garimamittal13/Quadrature-Oscillator/lowpass.asc

C1: cap; 47n
R1: res; 1.26k
V1: voltage; SINE(0 100m 10k); AC 1 0
Named nets: 0
.tran 2m
Vin
Vout
