garimamittal13/Quadrature-Oscillator/mixer+lowpass.asc

C1: cap; 47n
Cc: cap; 1.86µµ
M1: nmos4; CMOSN; l=1u w=3u ad=7.5uu as=7.5uu pd=11u ps=11u
R1: res; 1.26k
Rbias: res; 85.56k
RL: res; 1k
Vbias: voltage; 0.5
Vin: voltage; SINE(0 100m 95k)
Vosc: voltage; SINE(0 0.5 100k); AC 1 0
Named nets: 0, VIF
.include TSMC_180nm.txt
.tran 4m
