garimamittal13/Quadrature-Oscillator/oscillator.asc

C1: cap; {C}
C2: cap; {C}
C3: cap; {C}
R1: res; {R}
R2: res; {R}
R3: res; {R}
R4: res; 1k
R5: res; 1k
R6: res; 1k
U1: opamp2; UA741
U2: opamp2; UA741
V1: voltage; 5
V2: voltage; SINE(2.5 0.5 100k 3.65u)
Named nets: 0, Vc/2, Vc, cos, sin
.include UA741.301
.tran .2m
.param R = 65k
.param C = 10p
