garimamittal13/Quadrature-Oscillator/quad_oscillator.asc

C1: cap; {C}
C2: cap; {C}
C3: cap; {C}
C4: cap; 47n
C5: cap; 47n
C6: cap; 47n
C7: cap; 47n
Cc1: cap; 1.86µµ
Cc2: cap; 1.86µµ
M1: nmos4; CMOSN; l=1u w=3u ad=7.5uu as=7.5uu pd=11u ps=11u
M2: nmos4; CMOSN; l=1u w=3u ad=7.5uu as=7.5uu pd=11u ps=11u
R1: res; {R}
R2: res; {R}
R3: res; {R}
R4: res; 1.26k
R5: res; 1.26k
R6: res; 1.26k
R7: res; 1.26k
Rbias1: res; 85.56k
Rbias2: res; 85.56k
U1: opamp2; ua741
U2: opamp2; ua741
V1: voltage; 5
V2: voltage; 5
V3: voltage; 2.5
Vbias1: voltage; 0.5
Vbias2: voltage; 0.5
Vin1: voltage; SINE(0 100m 95k)
Vin2: voltage; SINE(0 100m 95k)
Named nets: 0
.include UA741.301
.tran 5m
.param R 15k
.param C 47p
.include TSMC_180nm.txt
